BryceGetsBuilding/HD-Kayak-Slings/cut-sheet.png

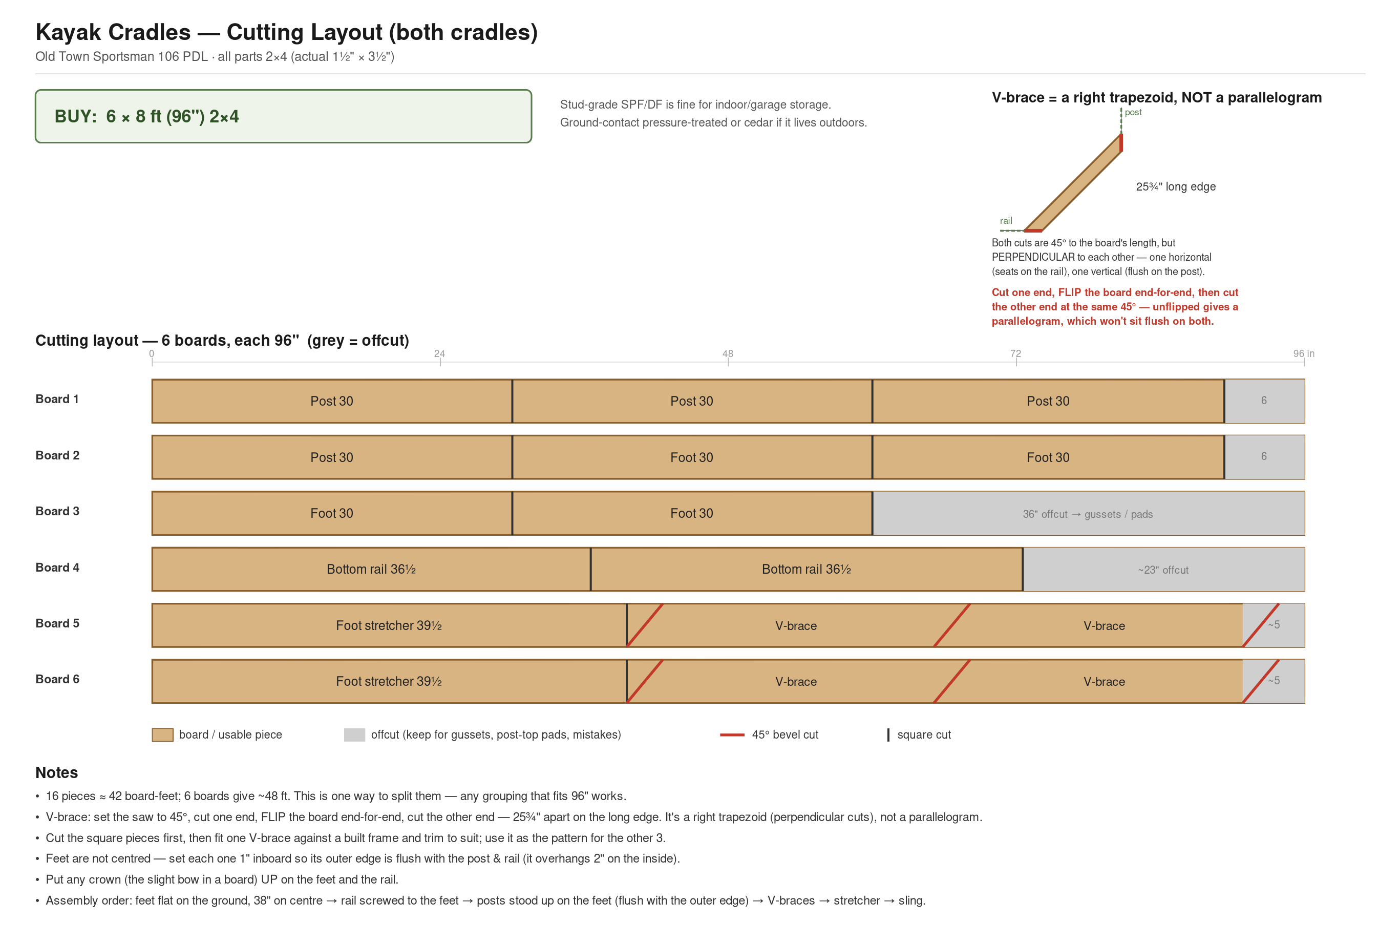
cut-sheet.png
