BryceGetsBuilding/HD-Kayak-Slings/cradle_model.FCStd

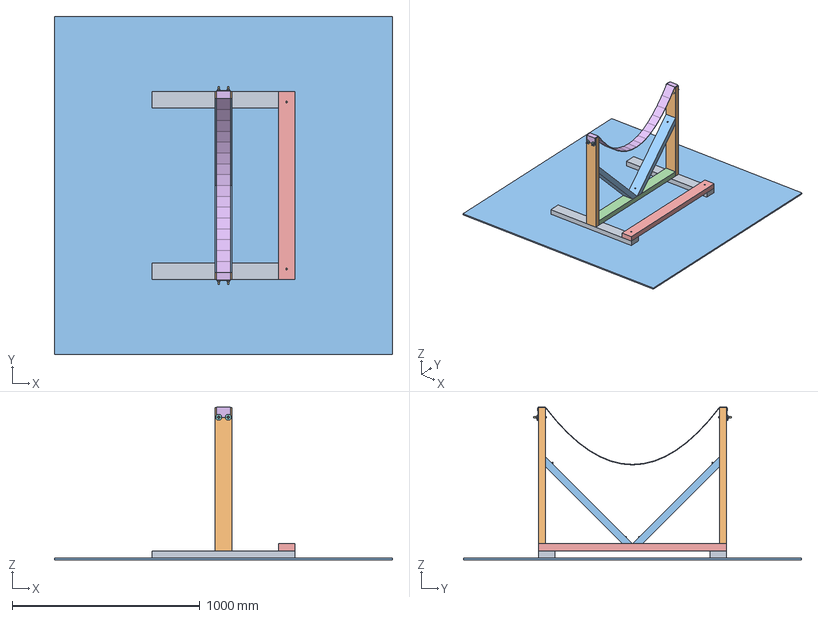
[picture p4: CAD file, 2026-10-20]
cradle_model.FCStd
1800.0 x 1800.0 x 813.0 mm
Foot x 2
Post x 2
V_Brace x 2
Bottom_Rail
Foot_Stretcher
webbing_sling_1
Carriage_Bolt x 4
Fender_Washer x 4
Hex_Nut x 4
Deck_Screw x 14
Studio_Floor
